benfreudberg/imu_board/mag_data_logging/Core/Src/main.c

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
/* Includes ------------------------------------------------------------------*/
#include "main.h"
#include "dma.h"
#include "spi.h"
#include "tim.h"
#include "usart.h"
#include "usb_device.h"
#include "gpio.h"

/* USER CODE BEGIN Includes */
#include <math.h>
#include "global_variables.h"
#include "initialize.h"
#include "usbd_cdc_if.h"
/* USER CODE END Includes */


/* USER CODE BEGIN PV */
volatile bool tim1_int = false;
/* USER CODE END PV */

void SystemClock_Config(void);
/* USER CODE BEGIN PFP */
void BootLocation(void);
void JumpToBootloader(void);
/* USER CODE END PFP */

/* USER CODE BEGIN 0 */
#define DEBUG_BUFFER_LENGTH   10
void CollectAndSendMagData() {
  static bool collect_mag = false;
  static int count_20ms = 0;
  static int16_t buffer[2][DEBUG_BUFFER_LENGTH][3];
  static bool buffer_bool = 0;

  float  MMC0_floats[3];
  static int16_t MMC0_raw[3];
  if (tim1_int) {
    //read mag
    if (collect_mag) {
      MMC5983MA_Read(&MMC0, MMC0_floats, MMC0_raw);

      for (int i = 0; i < 3; i++) {
        buffer[buffer_bool][count_20ms % DEBUG_BUFFER_LENGTH][i] = MMC0_raw[i];
      }
      if (count_20ms % DEBUG_BUFFER_LENGTH == DEBUG_BUFFER_LENGTH - 5) {
        static uint64_t sync_marker = 0x0123456789abcdef;
        CDC_Transmit_FS((uint8_t*)(&sync_marker), sizeof(sync_marker));
      }
      if (count_20ms % DEBUG_BUFFER_LENGTH == DEBUG_BUFFER_LENGTH - 1) {
        CDC_Transmit_FS((uint8_t*)(&(buffer[buffer_bool][0][0])), sizeof(buffer)/2);
        buffer_bool = !buffer_bool;
      }
      count_20ms++;
      count_20ms %= 50;
    } else {
      MMC5983MA_Start(&MMC0);
    }
    collect_mag = !collect_mag;
    tim1_int = false;
  }
}
void HAL_TIM_PeriodElapsedCallback(TIM_HandleTypeDef *htim) {
  if (htim == &htim1) {
    tim1_int = true;
  }
}
/* USER CODE END 0 */

/**
  * @brief  The application entry point.
  * @retval int
  */
int main(void)
{
  /* USER CODE BEGIN 1 */
//  BootLocation(); //doesn't work right
  /* USER CODE END 1 */

  /* MCU Configuration--------------------------------------------------------*/

  /* Reset of all peripherals, Initializes the Flash interface and the Systick. */
  HAL_Init();

  /* Configure the system clock */
  SystemClock_Config();

  /* Initialize all configured peripherals */
  MX_GPIO_Init();
  MX_DMA_Init();
  MX_SPI1_Init();
  MX_USART1_UART_Init();
  MX_USB_Device_Init();
  MX_TIM1_Init();
  MX_TIM4_Init();
  MX_TIM8_Init();
  /* USER CODE BEGIN 2 */
  Init();
  uint8_t aTxBuffer[2] = {0};
  uint8_t aRxBuffer[2] = {0};
  aTxBuffer[0] = Config_Reg1;
  aTxBuffer[1] = ODR100;
  HAL_GPIO_WritePin(MMC0.CS_Port, MMC0.CS_Pin, GPIO_PIN_RESET);
  HAL_SPI_TransmitReceive(MMC0.SPI_Bus, (uint8_t*) &aTxBuffer, (uint8_t*) &aRxBuffer, 2, 5);
  HAL_GPIO_WritePin(MMC0.CS_Port, MMC0.CS_Pin, GPIO_PIN_SET);
  /* USER CODE END 2 */

  /* Infinite loop */
  /* USER CODE BEGIN WHILE */
  while (1)
  {
    CollectAndSendMagData();
//    char message[] = "this is a test message\n";
//    CDC_Transmit_FS((uint8_t*)message, strlen(message));
//    HAL_Delay(500);
    /* USER CODE END WHILE */

    /* USER CODE BEGIN 3 */
  }
  /* USER CODE END 3 */
}

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
/* USER CODE BEGIN 4 */
void BootLocation(void) {
  __HAL_RCC_GPIOA_CLK_ENABLE();
  GPIO_InitTypeDef GPIO_InitStruct = {0};
  GPIO_InitStruct.Pin = BTN0_Pin;
  GPIO_InitStruct.Mode = GPIO_MODE_INPUT;
  GPIO_InitStruct.Pull = GPIO_PULLUP;
  HAL_GPIO_Init(GPIOA, &GPIO_InitStruct);

  if (!HAL_GPIO_ReadPin(GPIOA, BTN0_Pin)) {
    HAL_GPIO_DeInit(GPIOA, BTN0_Pin);
    __HAL_RCC_GPIOA_CLK_DISABLE();
    JumpToBootloader();
  }
}

/**
 * Function to perform jump to system memory boot from user application
 *
 * Call function when you want to jump to system memory
 */
void JumpToBootloader(void) {
  void (*SysMemBootJump)(void);

  /**
   * Step: Set system memory address.
   *
   *       For STM32F429, system memory is on 0x1FFF 0000
   *       For other families, check AN2606 document table 110 with descriptions of memory addresses
   */
  volatile uint32_t addr = 0x1FFF0000;

  /**
   * Step: Disable RCC, set it to default (after reset) settings
   *       Internal clock, no PLL, etc.
   */
#if defined(USE_HAL_DRIVER)
  HAL_RCC_DeInit();
#endif /* defined(USE_HAL_DRIVER) */
#if defined(USE_STDPERIPH_DRIVER)
  RCC_DeInit();
#endif /* defined(USE_STDPERIPH_DRIVER) */

  /**
   * Step: Disable systick timer and reset it to default values
   */
  SysTick->CTRL = 0;
  SysTick->LOAD = 0;
  SysTick->VAL = 0;

  /**
   * Step: Disable all interrupts
   */
  __disable_irq();

  /**
   * Step: Remap system memory to address 0x0000 0000 in address space
   *       For each family registers may be different.
   *       Check reference manual for each family.
   *
   *       For STM32F4xx, MEMRMP register in SYSCFG is used (bits[1:0])
   *       For STM32F0xx, CFGR1 register in SYSCFG is used (bits[1:0])
   *       For others, check family reference manual
   */
  //Remap by hand... {
//#if defined(STM32G4)
//  SYSCFG->MEMRMP = 0x01;
//#endif
//#if defined(STM32F4)
//  SYSCFG->MEMRMP = 0x01;
//#endif
//#if defined(STM32F0)
//  SYSCFG->CFGR1 = 0x01;
//#endif
//  //} ...or if you use HAL drivers
  __HAL_SYSCFG_REMAPMEMORY_SYSTEMFLASH(); //Call HAL macro to do this for you

  /**
   * Step: Set jump memory location for system memory
   *       Use address with 4 bytes offset which specifies jump location where program starts
   */
  SysMemBootJump = (void (*)(void)) (*((uint32_t *)(addr + 4)));

  /**
   * Step: Set main stack pointer.
   *       This step must be done last otherwise local variables in this function
   *       don't have proper value since stack pointer is located on different position
   *
   *       Set direct address location which specifies stack pointer in SRAM location
   */
  __set_MSP(*(uint32_t *)addr);

  /**
   * Step: Actually call our function to jump to set location
   *       This will start system memory execution
   */
  SysMemBootJump();

  /**
   * Step: Connect USB<->UART converter to dedicated USART pins and test
   *       and test with bootloader works with STM32 Flash Loader Demonstrator software
   */
}
/* USER CODE END 4 */
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
