benfreudberg/imu_board/headtracker_firmware/headtracker_firmware.ioc

Mcu.UserName=STM32G431KBTx
PA0.GPIO_Label=JMPR0
PA0.Signal=GPIO_Input
PA1.GPIO_Label=BTN1
PA1.Signal=GPXTI1
PA10.Signal=USART1_RX
PA11.Signal=USB_DM
PA12.Signal=USB_DP
PA13.Signal=SYS_JTMS-SWDIO
PA14.Signal=SYS_JTCK-SWCLK
PA2.GPIO_Label=BTN2
PA2.Signal=GPXTI2
PA3.Signal=GPIO_Output
PA5.Signal=SPI1_SCK
PA6.Signal=SPI1_MISO
PA7.Signal=SPI1_MOSI
PA8.GPIO_Label=CS_FRAM0
PA8.Signal=GPIO_Output
PA9.Signal=USART1_TX
PB0.GPIO_Label=CS_ICM0
PB0.Signal=GPIO_Output
PB3.Signal=GPIO_Output
PB4.GPIO_Label=T8_2N_LED0
PB4.Signal=TIM8_CH2N
PB5.GPIO_Label=T8_3N_LED1
PB5.Signal=TIM8_CH3N
PB6.GPIO_Label=T4_1_LED2
PB6.Signal=S_TIM4_CH1
PB7.GPIO_Label=CS_MMC0
PB7.Signal=GPIO_Output
PB8-BOOT0.GPIO_Label=BTN0
PB8-BOOT0.Signal=GPXTI8
PF0-OSC_IN.Signal=RCC_OSC_IN
PF1-OSC_OUT.Signal=RCC_OSC_OUT
