benfreudberg/imu_board/mag_data_logging/Core/Inc/main.h

#define JMPR0_Pin GPIO_PIN_0
#define JMPR0_GPIO_Port GPIOA
#define BTN1_Pin GPIO_PIN_1
#define BTN1_GPIO_Port GPIOA
#define BTN1_EXTI_IRQn EXTI1_IRQn
#define BTN2_Pin GPIO_PIN_2
#define BTN2_GPIO_Port GPIOA
#define BTN2_EXTI_IRQn EXTI2_IRQn
#define CS_ICM0_Pin GPIO_PIN_0
#define CS_ICM0_GPIO_Port GPIOB
#define CS_FRAM0_Pin GPIO_PIN_8
#define CS_FRAM0_GPIO_Port GPIOA
#define T8_2N_LED0_Pin GPIO_PIN_4
#define T8_2N_LED0_GPIO_Port GPIOB
#define T8_3N_LED1_Pin GPIO_PIN_5
#define T8_3N_LED1_GPIO_Port GPIOB
#define T4_1_LED2_Pin GPIO_PIN_6
#define T4_1_LED2_GPIO_Port GPIOB
#define CS_MMC0_Pin GPIO_PIN_7
#define CS_MMC0_GPIO_Port GPIOB
#define BTN0_Pin GPIO_PIN_8
#define BTN0_GPIO_Port GPIOB
#define BTN0_EXTI_IRQn EXTI9_5_IRQn
