benfreudberg/imu_board/(commit log)

2020-05-31 add buttons and leds
2020-06-04 add FRAM cs pin
2020-06-28 swap mmc5883 for mmc5983, finish board and create gerbers
2020-09-30 cmsis dsp library, copy usable source files, get main timer working, read from imu
2020-10-08 add/clean mmc5983ma driver, clean up some icm20602 code
2020-10-08 make imu data interpretation support all gyro ranges
2020-10-13 start of calibration
2020-10-15 kalman filter and mag calibration
2020-10-24 finish calibration (except led timer bug) including saving and loading from FRAM
    [FM25L16B.c, FM25L16B.h, calibration.c, calibration.h, global_variables.c, global_variables.h, initialize.c]
2020-11-03 trying to fix base rotation
    [calibration.c, global_variables.c, headtracker_firmware.ioc, main.c]
2020-11-13 add debug sensor data streaming
2020-11-18 setup orientation configuration to be stored in non-volatile memory as die faces for top and front
    [configuration.h]
2020-11-24 setup board v0.3
2020-12-04 added translation but it does not work well, automatic acc beta adjustment isn't working well - there might be an error
    [buttons.c, calibration.c, global_variables.c, global_variables.h, initialize.c, primary_loop.c]
2020-12-13 update gerbers to fix button cap connection
2022-03-31 expand mag calibration accepted range to cover location-variable field strength
2022-03-31 add comment describing source of default calibration values
2023-02-10 add mag data printing program
