benfreudberg/imu_board/(notices)

Notices in the files:
mag_data_logging/Core/Src/main.c:
© Copyright (c) 2020 STMicroelectronics.
All rights reserved.
This software component is licensed by ST under Ultimate Liberty license
mag_data_logging/Core/Inc/main.h:
(C) COPYRIGHT STMicroelectronics *****END OF FILE
